michaellomuscio/fulcrum/guide/guide.html

An ELEGOO starter kit project · reinforcement learning · sim to real

# FULCRUM

A cardboard robot that learns to balance a ball in a dream, then does it for real.

- about 3 hours
- no soldering, no 3D printer
- 30 narrated steps, 16 minutes
- brain trains in about a minute

▶ Play the narrated walkthrough Open the Gym

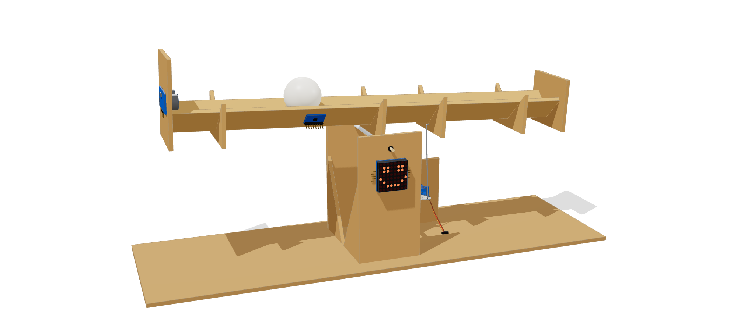
[picture p1: guide/img/hero-wide.png]
The finished Fulcrum: a cardboard V-track on a skewer pivot between two towers, a blue servo with a paperclip push-rod, an ultrasonic sensor at the left end, an LED face, and a ping-pong ball on the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
 the finished robot

0.1

### Welcome

You'll build a robot from a shipping box and your ELEGOO kit that keeps a ping-pong ball wherever you point, on a track that tilts. Nobody writes its balancing rules. A small neural network learns them by reinforcement learning in a simulator you can watch, the Gym. You then send that brain down the USB cable into the Arduino and see whether what it learned in the dream holds up in reality.

Everything here was tested before you build it: the firmware was run on a computer against the simulated robot, calibration was tried on hundreds of deliberately crooked simulated builds, and the brain you'll train beats a hand-tuned classic controller. What I couldn't test is your actual cardboard. That's the experiment.

Done

0.2

### How it works

The trick that makes a dream-trained brain survive reality is domain randomization. Every practice run, the simulator re-rolls the robot's quirks: how sticky the track is, how slow and sloppy the servo is, how noisy the sonar is, how crooked "level" is. A brain that balances in all of those worlds has a good chance in yours.

Done

0.3

### What you need

#### From the kit (names as on the lid)

- UNO R3 Controller Board×1
- USB Cable×1
- 830 Tie-Points Breadboard×1
- Power Supply Module×1
- 9V1A Adapter×1
- Servo Motor SG90 with its bag of plastic arms (horns)×1
- Ultrasonic Sensor the one with two silver "eyes"×1
- GY-521 Module×1
- MAX7219 Module the 8×8 LED matrix×1
- IR Receiver Module and Remote Control×1
- Active Buzzer sticker on top, sealed black bottom×1
- Potentiometer 10K the knob×1
- 100uF Electrolytic Capacitor×1
- Breadboard Jumper Wire×14
- Female-to-Male Dupont Wire×13

#### From home

- Corrugated cardboard one medium shipping box
- Ping-pong ball or a golf ball, or a small rubber ball×1
- Bamboo skewers×2
- Plastic drinking straw×1
- Large paperclip×1
- Hot glue gun and sticks
- Box cutter or sturdy scissors, ruler, pencil
- Double-sided tape or poster putty; clear packing tape is a bonus
- USB-C to USB-A adapter your MacBook's ports are USB-C; the kit cable isn't×1

Done

Part 1

## Build the beam

All cardboard. Hot glue sets in about a minute; hold each joint square until it does. The end with the sensor is "the sonar end" and is at 0 in on every measurement.

1.1

### Cut the cardboard

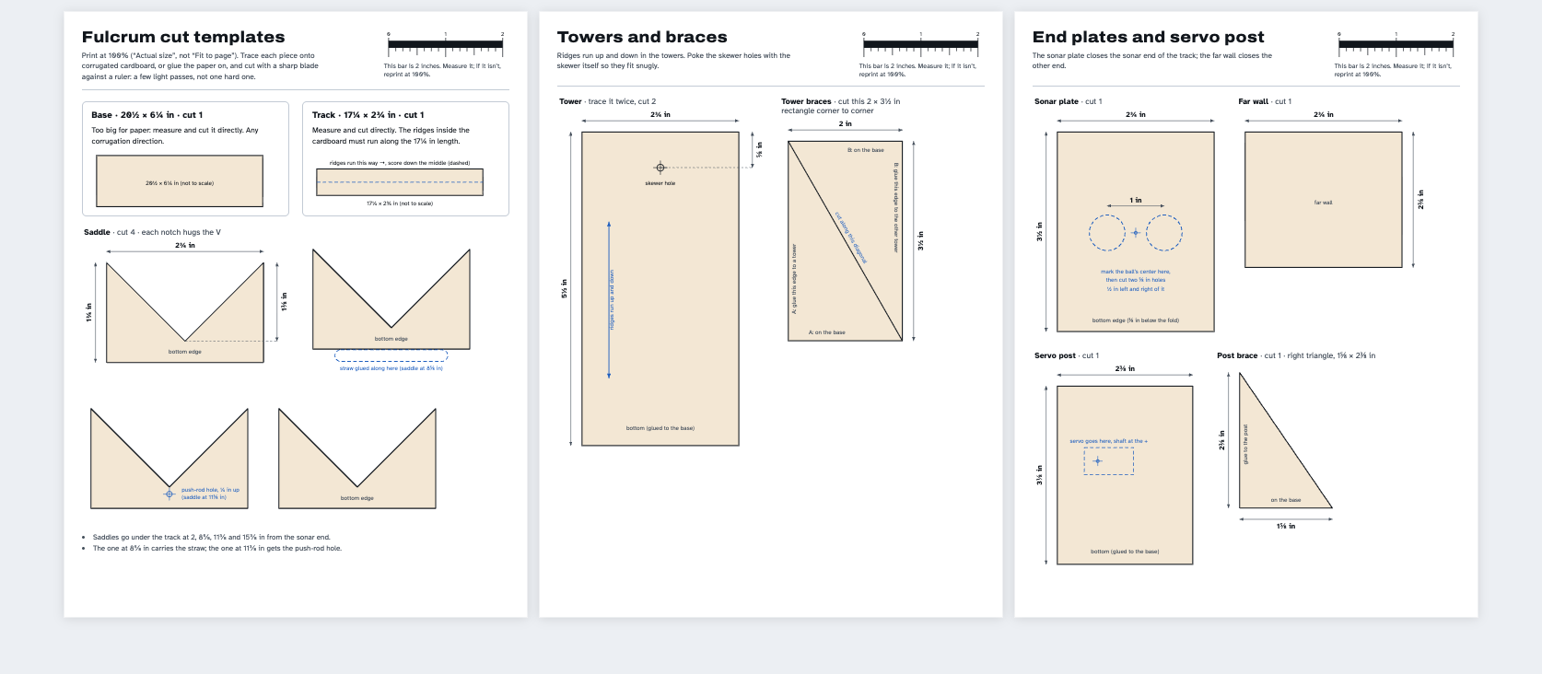
[picture p2: guide/img/templates-preview.png]
Printable cut templates with the small parts drawn at actual size.


Three letter-size pages. Print at 100% (actual size), then check the 2 inch bar with a ruler.

Save the cut templates (PDF)Open them on GitHub (https://github.com/michaellomuscio/fulcrum/blob/main/guide/fulcrum-cut-templates.pdf)

The same file is guide/fulcrum-cut-templates.pdf in the fulcrum folder.

1. Cut the base, 20½ × 6¼ in.
2. Cut the track strip, 17¼ × 2¾ in, with the corrugation (the ridges inside the cardboard) running the 17¼ in way. That keeps it straight.
3. Print the templates, cut them out, trace onto cardboard, and cut: 4 saddles, 2 towers, 2 tower braces, the sonar plate, the far wall, the servo post and its brace.

Clean cuts: several light passes with a sharp blade against a metal ruler beat one hard push. Cut on something you don't mind scratching.

Done

1.2

### Fold the track

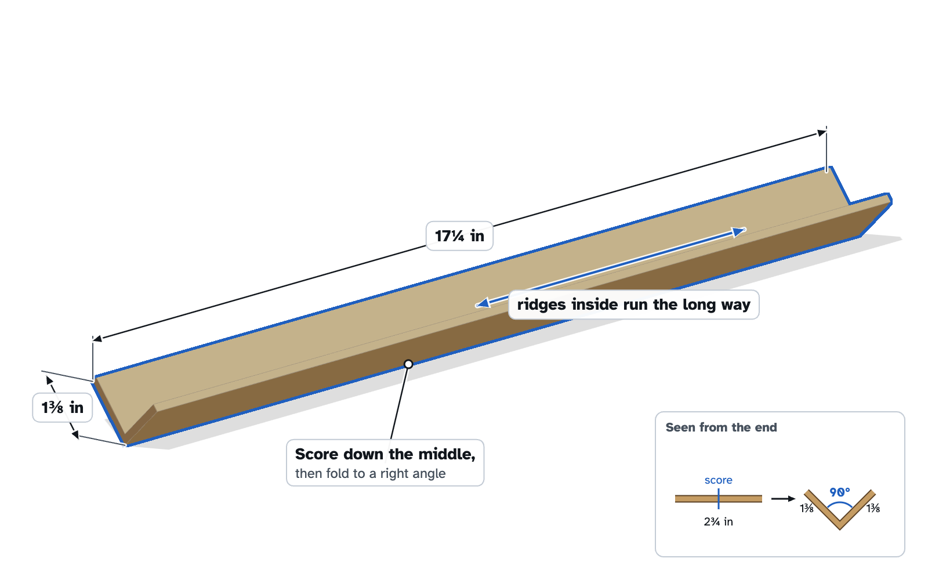
[picture p3: guide/img/build-1-fold.png]
The 17¼ by 2¾ inch strip scored down its middle and folded into a 90 degree V.


1. Draw a line down the middle of the track strip, 1⅜ in from each long edge.
2. Score it: press the back of a butter knife (or a dry ballpoint) firmly along the line, against a ruler.
3. Fold along the score into a V with a right angle, score on the outside.
4. Optional: run clear packing tape down the inside of each face for a smoother, more even roll.

Done

1.3

### Saddles and straw

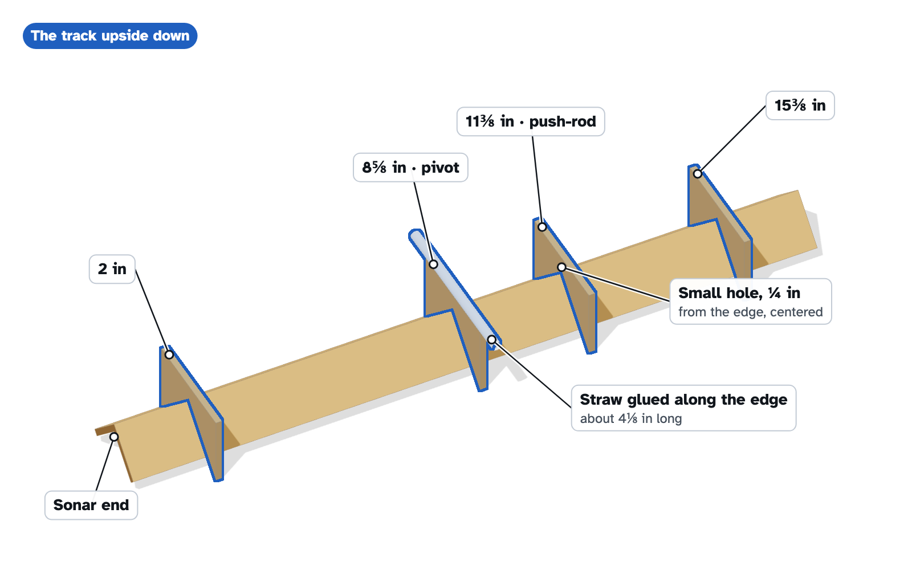
[picture p4: guide/img/build-2-saddles.png]
The track seen from below with four notched saddles at 2, 8⅝, 11⅜ and 15⅜ inches; a straw across the 8⅝ inch saddle and a small hole in the 11⅜ inch saddle.


1. On the outside of the V, mark across it at 2, 8⅝, 11⅜ and 15⅜ in from the sonar end.
2. Cut a straw to 4⅛ in and glue it along the bottom edge of one saddle, centered. That's the pivot saddle.
3. In a second saddle, poke a small hole ¼ in above its bottom edge, centered, with a skewer tip. That's the push-rod saddle.
4. Glue the saddles on the marks with their notches hugging the V: pivot saddle at 8⅝, push-rod saddle at 11⅜, the plain ones at 2 and 15⅜. The straw runs across the track.

Done

1.4

### Sonar plate and far wall

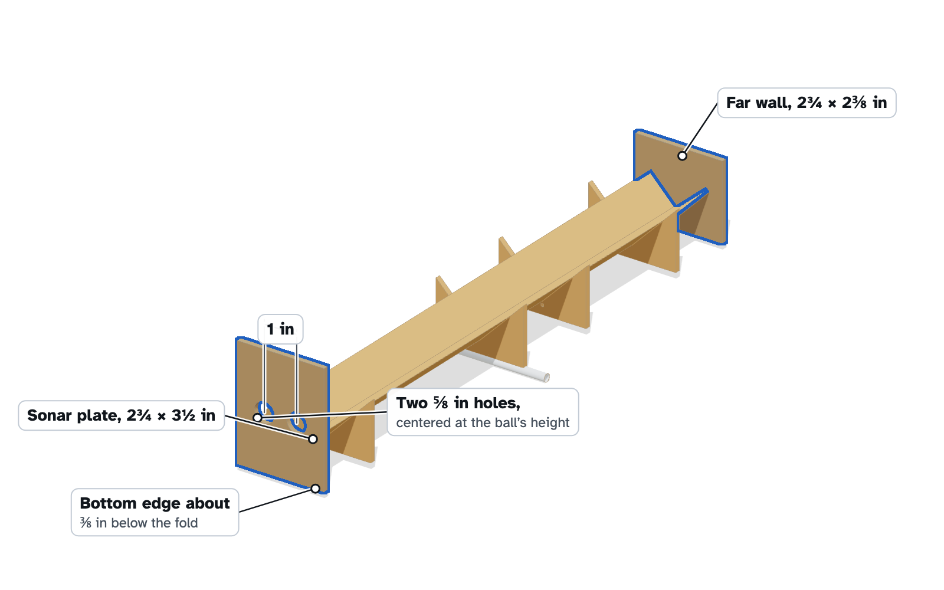
[picture p5: guide/img/build-3-ends.png]
The sonar plate with two round holes across the sonar end of the track, and the far wall across the other end.


1. Hold the sonar plate across the sonar end, set the ball in the V against it, and mark the plate at the height of the ball's center.
2. Draw two ⅝ in circles centered ½ in left and right of the mark (1 in apart), and cut them out. The sensor's silver cans should just fit.
3. Glue the plate across the end, centered on the V, its bottom edge about ⅜ in below the fold.
4. Glue the far wall across the other end.

Done

1.5

### Towers

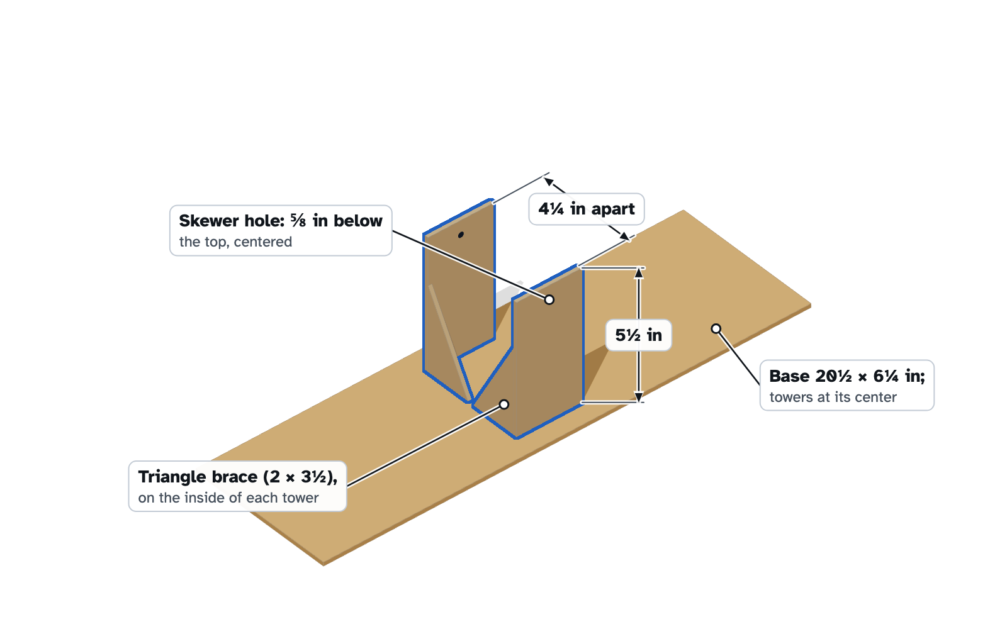
[picture p6: guide/img/build-4-towers.png]
Two cardboard towers standing on the base, 4¼ inches apart, each with a skewer hole ⅝ inch below the top and a triangular brace on its inside face.


1. Poke a skewer hole in each tower, ⅝ in below the top, centered.
2. Draw a line across the base at its middle (10¼ in from either end). Glue the towers upright on that line, facing each other, 4¼ in apart (inside faces), centered across the base.
3. Before the glue sets, slide a skewer through both holes so they line up.
4. Glue a triangle brace against the inside face of each tower, along the edge nearest the sonar end. (On the outside they'd hang off the base.)

Done

1.6

### Hang the beam

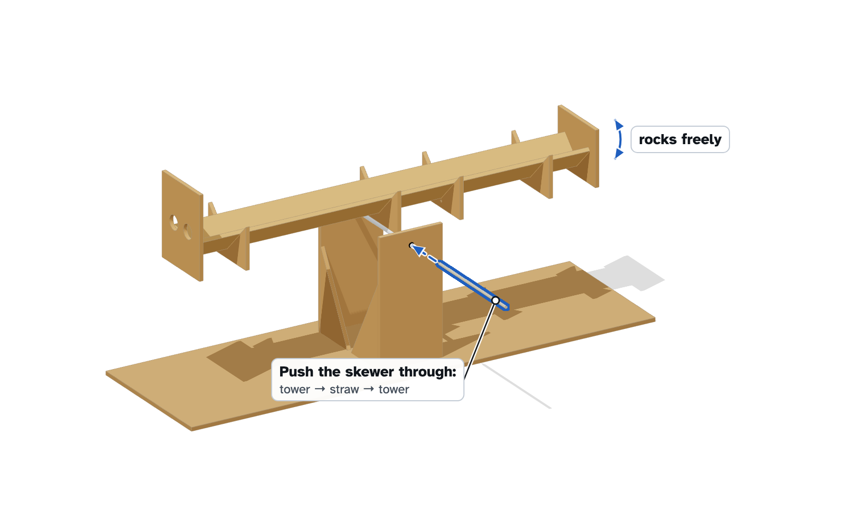
[picture p7: guide/img/build-5-hang.png]
The track hanging on a skewer that passes through one tower, the straw, and the other tower.


1. With the sonar end on your left, push a skewer through one tower, through the straw, and out the other tower.
2. Nudge the beam. It should rock freely and settle without sticking. If it rubs, trim the straw.
3. Trim the skewer so about ½ in sticks out past each tower.

The servo goes on in Part 4, once the electronics have been tested.

Done

Part 2

## Wire the electronics

Do this on the table, in front of the robot near the sonar end, with nothing plugged into your Mac or the wall. In each diagram the new wires are in full color and earlier ones are faded. Any hole on the correct rail works; the diagrams show a tidy layout that keeps everything in the left half of the board.

2.1

### Power

Wiring diagram: the power supply module on the left end of the breadboard; Arduino 5V and GND to the bottom rails; a ground bridge between the blue rails.

1. Press the Power Supply Module onto the left end of the breadboard: its − pins on the blue stripes, + pins on the red stripes, DC jack facing out.
2. Top jumper on 5V. Bottom jumper on OFF.
3. Red jumper: Arduino 5V → bottom red (+) rail. Black jumper: Arduino GND → bottom blue (−) rail.
4. Black jumper: top blue rail → bottom blue rail, so both supplies share a ground.

Why two supplies: the servo pulls sudden bursts of current that would jolt the sensors' readings. The top rail (power module) feeds only the servo; the bottom rail (the Arduino's own 5 V) feeds everything else.

Done

2.2

### Servo

Wiring diagram: capacitor across the top rails; servo brown to top blue, red to top red, orange to pin 9.

From | To
Capacitor, long leg | top red (+) rail
Capacitor, striped leg | top blue (−) rail (polarity matters)
Servo brown | top blue (−) rail
Servo red | top red (+) rail
Servo orange | Arduino pin 9

Done

2.3

### Ultrasonic sensor

Wiring diagram: HC-SR04 VCC to bottom red rail, Trig to pin 7, Echo to pin 8, Gnd to bottom blue rail.

Sensor pin | Female-to-male wire to
VCC | bottom red (+) rail
Trig | Arduino pin 7
Echo | Arduino pin 8
Gnd | bottom blue (−) rail

Done

2.4

### Motion sensor (GY-521)

Wiring diagram: GY-521 VCC and GND to the bottom rails, SCL to A5, SDA to A4.

Board pin | Female-to-male wire to
VCC | bottom red (+) rail
GND | bottom blue (−) rail
SCL | Arduino A5
SDA | Arduino A4
XDA, XCL, AD0, INT | nothing

ELEGOO ships this board with either an MPU-6050 or a QMI8658 chip. The firmware finds whichever you have.

Done

2.5

### Knob

Wiring diagram: potentiometer legs in three columns; left to the bottom blue rail, middle to A0, right to the bottom red rail.

1. Push the knob's three legs into three different columns (some knobs need every other column).
2. Left leg → bottom blue rail. Middle leg → A0. Right leg → bottom red rail.

If turning the knob moves the target the opposite way from what you'd like, swap the two outer wires.

Done

2.6

### LED face

Wiring diagram: MAX7219 module VCC and GND to the bottom rails, DIN to pin 11, CS to pin 10, CLK to pin 13.

Matrix pin | Female-to-male wire to
VCC | bottom red (+) rail
GND | bottom blue (−) rail
DIN | Arduino pin 11
CS | Arduino pin 10
CLK | Arduino pin 13

Done

2.7

### Remote receiver

Wiring diagram: IR receiver module pins G, R, Y in three columns; G to the bottom blue rail, R to the bottom red rail, Y to pin 2.

1. Plug the receiver into three columns with its dark dome facing the front edge of the breadboard.
2. G → bottom blue rail. R → bottom red rail. Y → Arduino pin 2.

Done

2.8

### Buzzer

Wiring diagram: active buzzer plus leg to pin 3, minus leg to the bottom blue rail.

1. Use the active buzzer: sticker on top, sealed black bottom. (The passive one shows a green circuit board underneath.)
2. Longer leg (marked +) → Arduino pin 3. Other leg → bottom blue rail.

Done

2.9

### Check the wiring

The complete wiring diagram.

Arduino pin | Goes to
D2 | remote receiver Y
D3 | buzzer +
D7 | sonar Trig
D8 | sonar Echo
D9 | servo orange
D10 | LED matrix CS
D11 | LED matrix DIN
D13 | LED matrix CLK
A0 | knob middle leg
A4 | GY-521 SDA
A5 | GY-521 SCL
5V, GND | bottom red and blue rails

Three things to double-check: the capacitor's stripe faces the blue rail; the power module's + and − line up with the red and blue stripes; and nothing from the bottom rails touches the top red rail, which belongs to the servo alone.

Done

Part 3

## Bring it to life

Everything from here on happens in the Gym, a web app in the fulcrum folder on your Mac. It has three tabs: Dream (training), Exam (testing) and Robot (the USB connection).

3.1

### Open the Gym

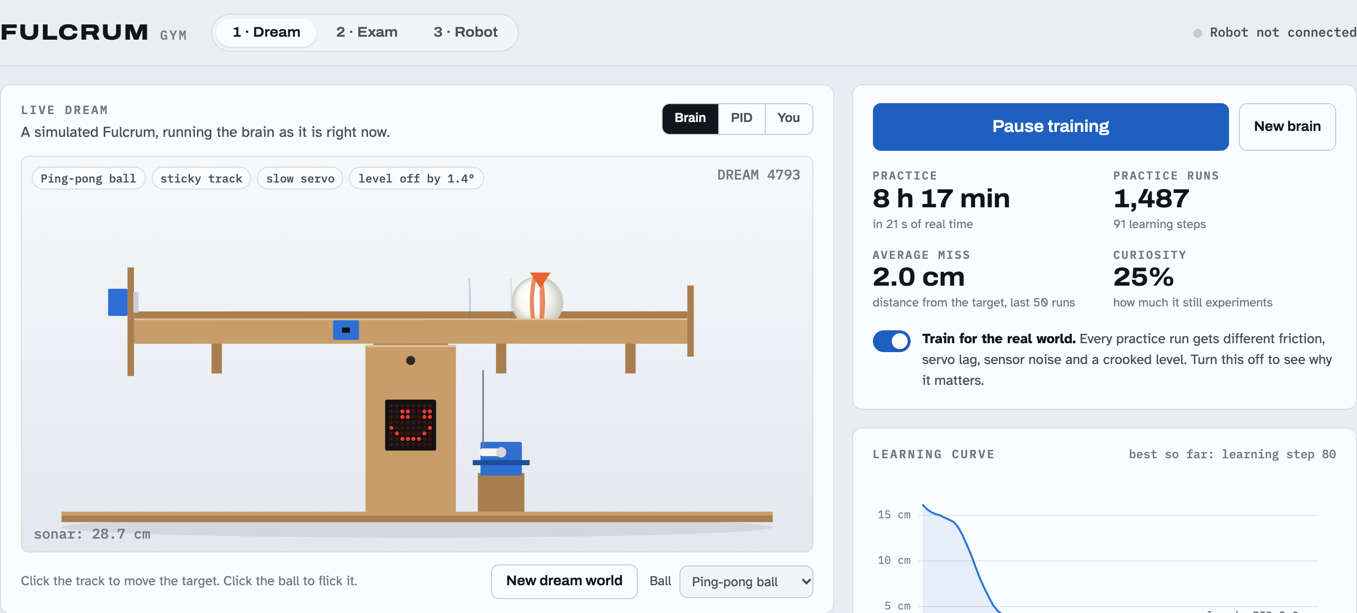
[picture p8: guide/img/gym-dream.png]
The Gym's Dream tab: a simulated Fulcrum, practice thumbnails, a learning curve and the brain's decision map.


1. Open the Gym in Chrome at michaellomuscio.github.io/fulcrum/gym. It can reach the Arduino over USB from there.
2. Or run it from your Mac, which also works offline: in Finder, open the fulcrum folder and double-click Fulcrum Gym.command. Chrome shows the Gym at localhost:8642/gym/; keep the small Terminal window open while you work. (Not on a Mac? Run python3 -m http.server 8642 in the folder.)

USB needs Chrome or Edge; Safari and Firefox don't support it. A Gym opened from inside claude.ai can train, run exams and drive a virtual robot, but can't reach USB.

Done

3.2

### Install the firmware

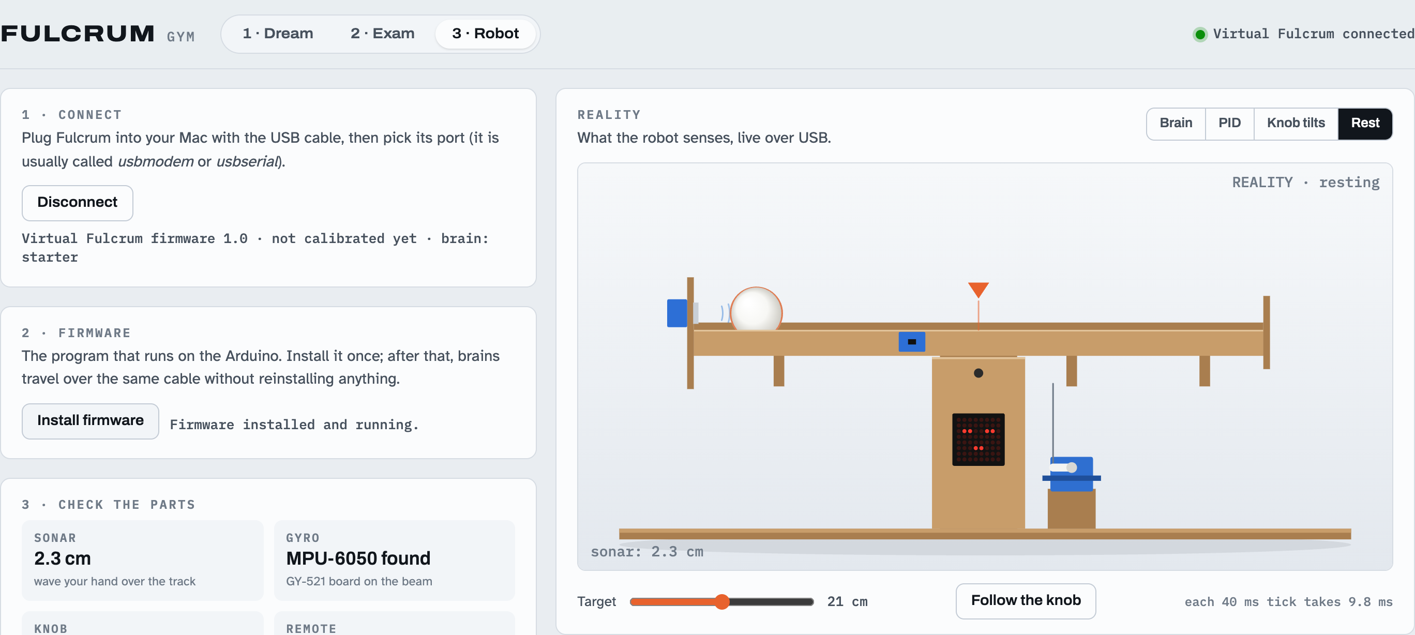
[picture p9: guide/img/gym-firmware.png]
The Robot tab after connecting and installing the firmware.


1. Plug the Arduino into your Mac (through the USB-C adapter).
2. In the Robot tab, click Connect and pick the port named like usbmodem… or usbserial….
3. Click Install firmware. About ten seconds later Fulcrum beeps twice and the status line says hello.

Plan B, the Arduino IDE: open fulcrum/firmware/Fulcrum/Fulcrum.ino, choose Tools › Board › Arduino Uno and your port, then Upload. No extra libraries are needed. Or flash it from Terminal with arduino-cli (see the README).

Done

3.3

### Test every part

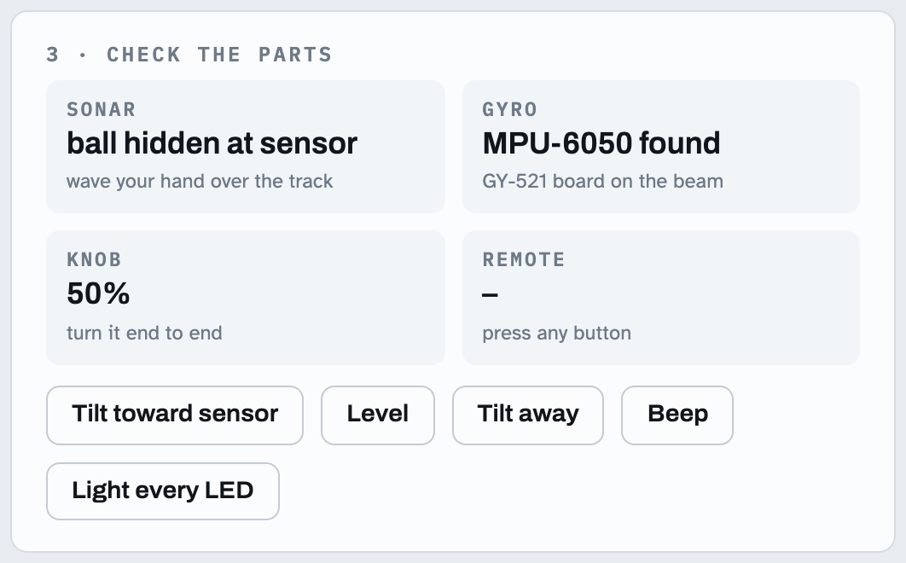
[picture p10: guide/img/gym-checks.png]
The Check the parts panel with live sonar, gyro, knob and remote readings.


1. Plug the 9 V adapter into the power module and press its button (its LED lights).
2. Wave a hand over the sonar: the reading changes. The gyro says found. Turn the knob end to end. Press any remote button.
3. Click Beep and Light every LED.
4. Click Tilt toward sensor, Level and Tilt away: the servo's shaft turns.

Something silent? See Troubleshooting. Fixing it now, with everything on the table, is much easier than later.

Done

Part 4

## Finish the robot

Mount the servo while the firmware holds it at its exact middle, then move the sensors onto the beam and let Fulcrum calibrate itself.

4.1

### Servo and push-rod

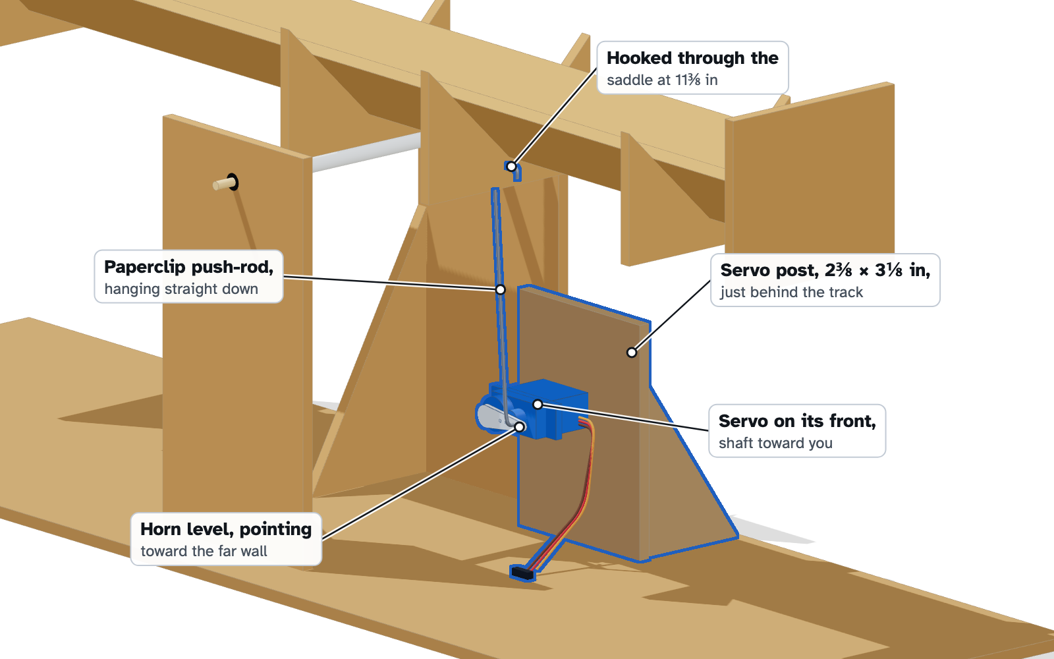
[picture p11: guide/img/build-6-servo.png]
The servo glued to a cardboard post behind the track, its arm horizontal toward the far wall, a paperclip rod rising to the saddle at 11⅜ inches.


1. Click Level in the Gym so the servo holds its middle position.
2. Glue the servo post to the base right behind the push-rod saddle (11⅜ in), its front face 1⅜ in behind the track's center line, and add its brace behind it.
3. Glue the servo to the post's front face with the shaft pointing toward you, about 2 in above the base, just left of the push-rod saddle (by the length of the arm).
4. Push the long single arm onto the shaft, pointing at the far wall, as close to horizontal as the teeth allow.
5. Straighten the paperclip. Hook one end through the arm's outermost hole and squeeze the hook closed; hook the top end through the saddle's hole the same way. Bend the rod until the beam sits close to level.

No glue on the rod's joints. They have to pivot.

Done

4.2

### Mount the sensors

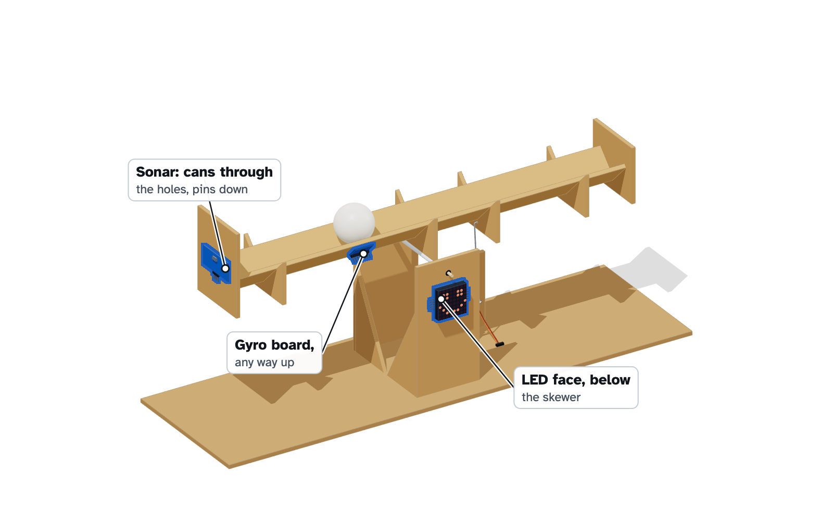
[picture p12: guide/img/build-7-sensors.png]
The ultrasonic sensor through the plate's holes, the GY-521 on the track's side, and the LED matrix on the front tower.


1. Push the ultrasonic sensor's cans through the plate's holes from outside, pins pointing down, and tape the board in place.
2. Stick the GY-521 to the outside of the track near 6 in with double-sided tape. Any orientation works; calibration figures it out.
3. Stick the LED matrix to the front tower below the skewer, facing you.
4. Route the wires loosely so the beam swings without tugging on them.

Done

4.3

### Calibrate

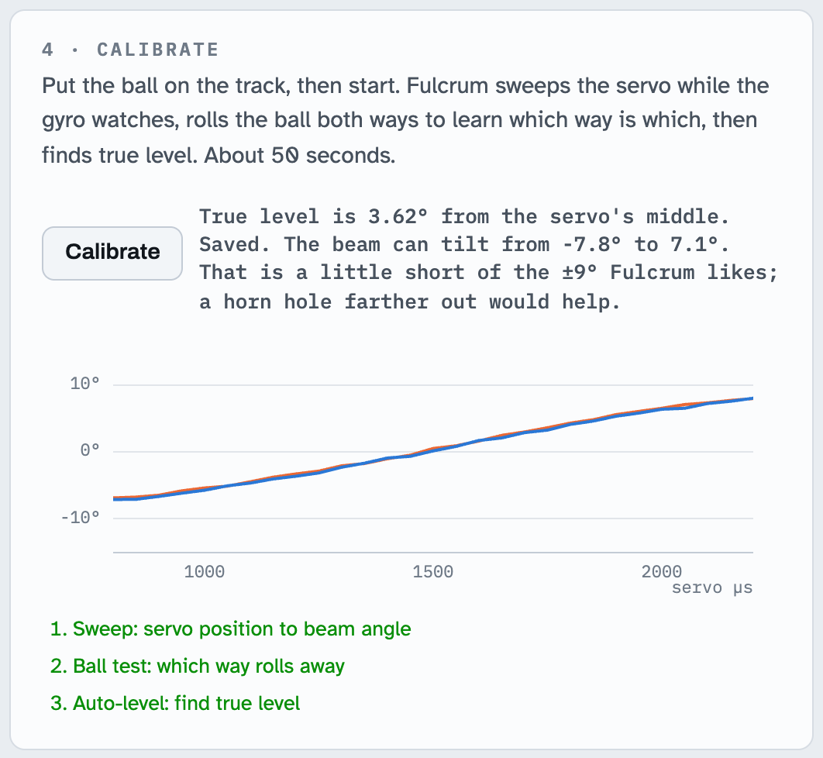
[picture p13: guide/img/gym-calibrate.png]
The calibration panel: a curve of beam angle against servo position, and three completed calibration steps.


1. Put the ball on the track and click Calibrate (or press ST/REPT on the remote). It takes about 50 seconds.
2. Sweep: the servo moves slowly end to end while the gyro measures the beam, giving a map from servo position to beam angle.
3. Ball test: it tilts one way, back, and again, and watches which way the ball rolls.
4. Auto-level: it holds the ball mid-track and nudges until it finds true level. The result is saved on the Arduino.

If it reports that the ball didn't roll, check that the ball is on the track and that the beam sits roughly level at rest (adjust the push-rod's bends), then calibrate again.

Done

Part 5

## Teach it

The robot can already balance with the starter brain I trained. Now train your own, examine it, and send it over.

5.1

### Train a brain

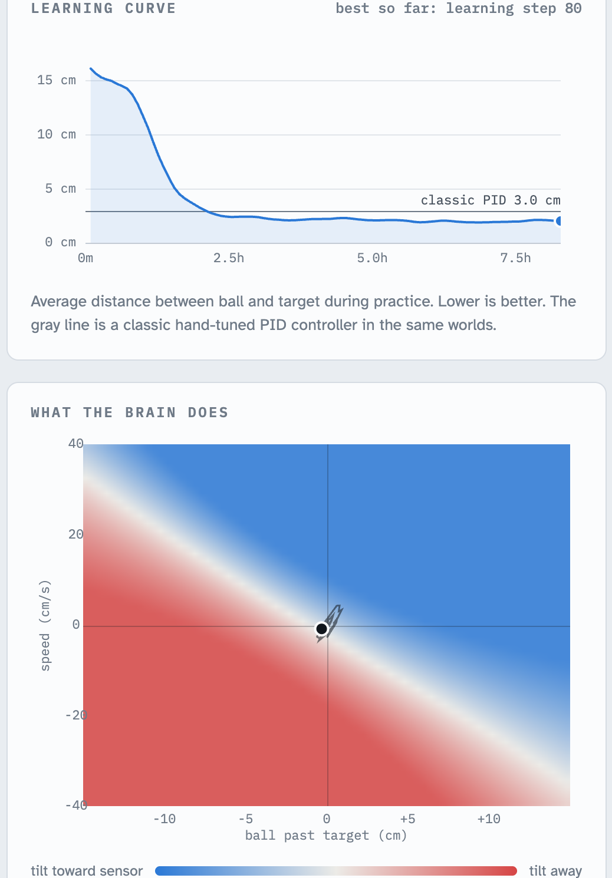
[picture p14: guide/img/gym-train.png]
The Dream tab during training: the learning curve dropping below the classic controller's line, and the brain's decision map.


1. In the Dream tab, press Start training. Sixty-four simulated Fulcrums practice at once, each with different physics.
2. Watch the learning curve: it climbs while the brain explores, then drops below the gray line, the score of a classic hand-tuned controller.
3. Watch What the brain does: a clean diagonal forms as it learns that the right tilt depends on both where the ball is and how fast it rolls.
4. Two or three minutes is plenty. Click the track to move the target, click the ball to flick it, or press You and try balancing it yourself.

Done

5.2

### The exam

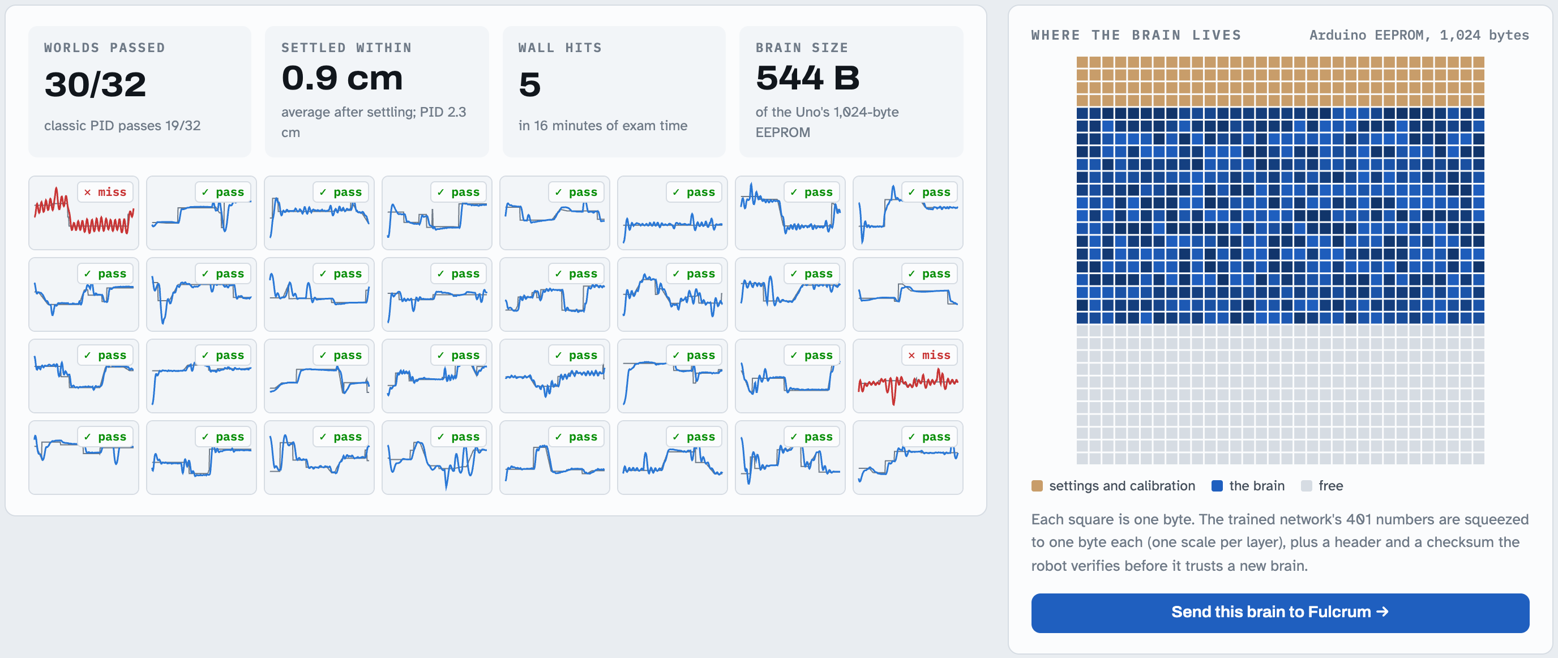
[picture p15: guide/img/gym-exam.png]
The Exam tab: 32 small charts of exam worlds with pass marks, score tiles, and a map of the Arduino's memory.


1. Open Exam, choose Best so far, and click Run the exam.
2. It's graded on the 544-byte, 8-bit copy the Arduino will run. Passing most of the 32 worlds means it's ready.

Done

5.3

### Send the brain

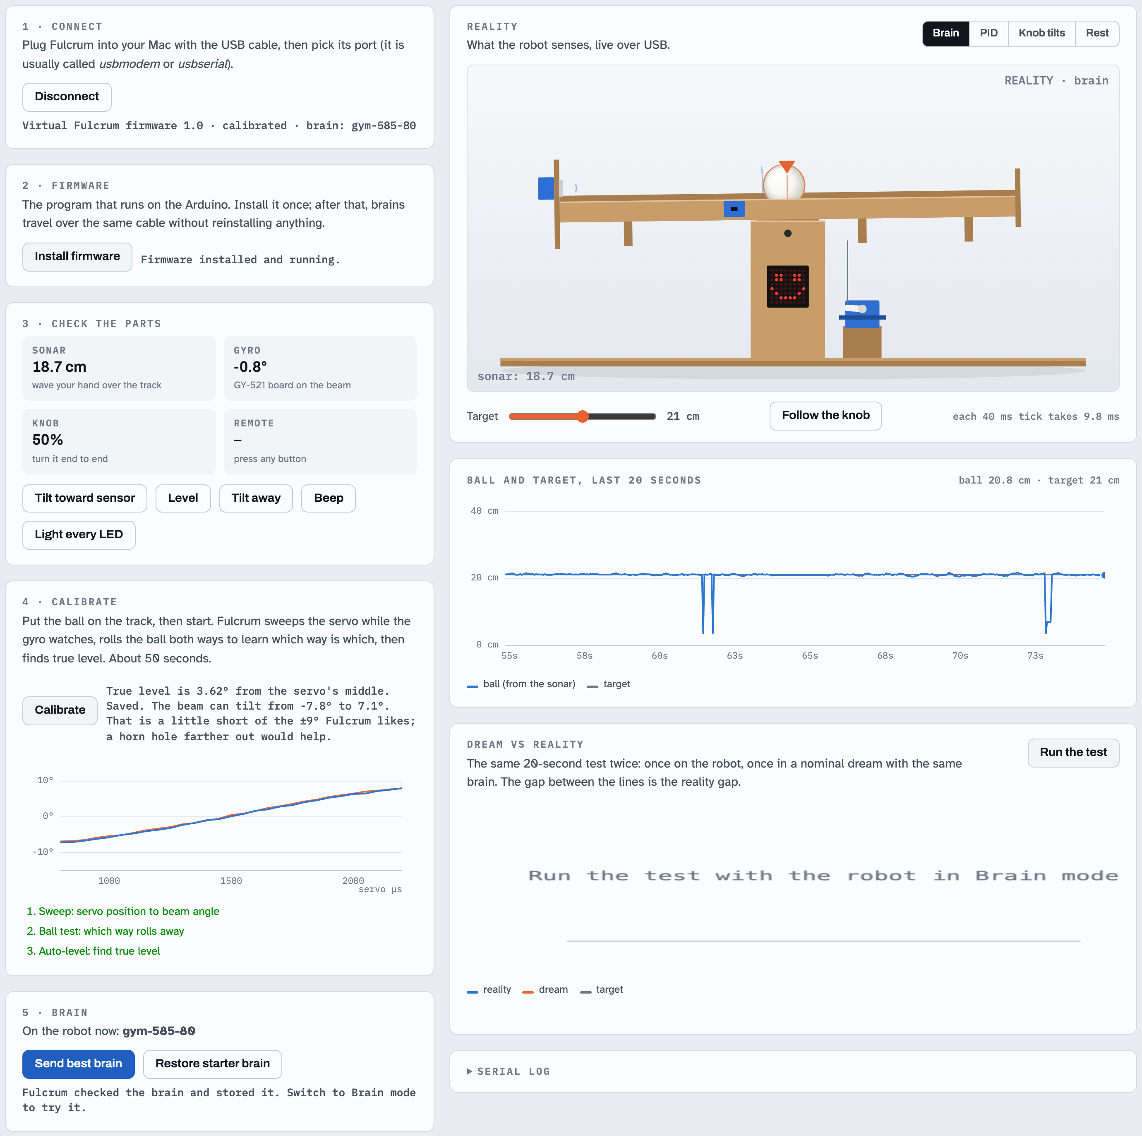
[picture p16: guide/img/gym-send.png]
The Robot tab's brain panel after sending a new brain, with the live view in Brain mode.


1. In Robot, click Send best brain. The Arduino checks every piece and stores the brain in memory that survives power-off.
2. Choose Brain mode, set the ball on the track, and let go.

Done

5.4

### Play with it

Button | What Fulcrum does
POWER or ▶❚❚ | start balancing, or rest
FUNC/STOP | switch brain → classic PID → knob tilts the beam (you're the brain)
1 … 9 | send the ball to a spot: 1 is nearest the sensor, 9 is farthest
0 | hand the target back to the knob
▲ ▼ | nudge the target 1 cm
VOL+ VOL− | fine-tune level by 0.05°
◀◀ ▶▶ | face, neurons, or a tiny copy of the beam on the LED matrix
EQ | buzzer on or off
ST/REPT | calibrate

Unplugged from the Mac, Fulcrum keeps its brain and calibration. Power the Arduino with the 9 V battery (or a USB power bank) and the servo with the adapter, then press POWER on the remote.

Done

5.5

### Dream vs reality

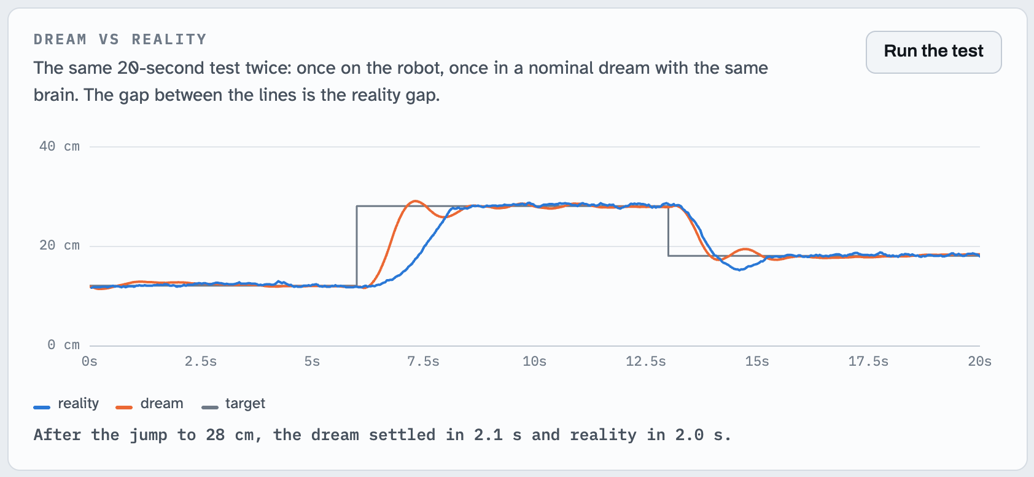
[picture p17: guide/img/gym-dreamreal.png]
Chart: the ball's position on the robot and in the simulator during the same 20-second routine of target changes.


1. In Robot, with Brain mode on, click Run the test. Fulcrum runs a 20-second routine of target jumps on the real track, then the Gym dreams the same routine with the same brain.
2. The space between the blue and orange lines is the reality gap. Small gap: the dream was a good model of your cardboard.

The screenshot above is the virtual robot, whose physics are deliberately different from the dream's. Yours will tell you how good the simulator really is.

Done

5.6

### Experiments

1. Skip the randomization. Turn off Train for the real world, train a new brain, send it. It aces its one perfect dream and struggles on real cardboard.
2. Change the ball. Try a golf ball (pick it in the Gym first). Does the brain cope with a heavier, faster ball?
3. Watch it learn from scratch. Press New brain and keep your eye on the decision map. The moment the diagonal appears is when it figured out balancing.
4. Beat the classic controller. Run the dream-vs-reality test in Brain mode and in PID mode and compare.
5. Be the brain. FUNC/STOP until the knob tilts the beam, and try to hold the ball still. Then let the brain have it back.

Done

Reference

## Troubleshooting

What you see | Usual cause and fix
No port to pick in Connect | Try another cable or adapter (some USB-C adapters are charge-only). Use Chrome; Safari has no USB support.
Connected, but no hello | Firmware not installed yet: click Install firmware. Or the Arduino IDE's Serial Monitor is open and holding the port; close it.
Install firmware says it can't reach the bootloader | Unplug and replug the Arduino, reconnect, try again. Still failing: use Plan B (Arduino IDE).
Sonar: no echo | Trig and Echo swapped (pin 7 is Trig, 8 is Echo), or VCC/Gnd loose. The cans must face down the track.
Gyro: not found | SDA/SCL swapped (SDA is A4, SCL is A5) or VCC loose. Fulcrum still works without it, with a less precise calibration.
Servo doesn't move, or twitches and the Arduino resets | Power module off or the 9 V adapter unplugged; top jumper not on 5V; capacitor backwards; servo red wire on the bottom rail.
Remote does nothing | Y must go to pin 2; aim at the receiver's dome; replace the remote's coin cell (pull the plastic tab out first).
LED face is sideways or upside down | Click Rotate face in the Gym's Check the parts panel until it looks right (it remembers).
Ball always runs off to one end | Calibrate again with the ball on the track. If the ball test fails, the beam is far from level at rest: re-bend the push-rod.
Ball hunts back and forth around the target | Loose push-rod joints add slop (tighten the hooks, but keep them free to turn). Train a little longer. Make sure the wires aren't tugging the beam.

Reference

## How it works, for the curious

The real equations behind the simulator, the learner and the robot.

### The physics in the dream

Put the pivot at the origin, let s be the ball's position along the track measured from the pivot, θ the beam angle (positive tips the far end down), h the height of the ball's center above the pivot, rc the ball's rolling radius on the V, m and J its mass and moment of inertia. Rolling without slipping makes the ball's spin ω = ṡ/rc + θ̇, so

kinetic energy of the ball's center and its spin, minus gravity

differentiate the momentum along the track

centrifugal push and gravity's pull along the track

Euler–Lagrange, divided through by m + J/rc²

A ping-pong ball is a thin shell, J = ⅔mr², and in a 90° V it rolls on a radius rc = r/√2, so k = 1/(1 + 4/3) = 3/7 ≈ 0.43: only 43% of gravity's pull along the track becomes acceleration; the rest spins the ball. The heffθ̈ term is the kick the ball gets when the beam jerks. The simulator adds rolling friction that sticks below a threshold, bumps in the cardboard, a servo modeled as a stiff damped spring with dead time, speed and torque limits, gear slop, and an ultrasonic sensor with noise, dropouts, garbage echoes and a blind spot.

### What the brain sees and does

The sonar's readings go through an alpha-beta tracker (the same arithmetic on the Arduino and in the dream):

The brain is a 6 → 16 → 16 → 1 network with tanh neurons. Its inputs are the miss e = x̂ − target (scaled by 15 cm), the speed (scaled by 40 cm/s), its last two tilts, the integral of the miss (scaled by 0.05 m·s), and where the ball is. Its output, between −1 and 1, is the tilt in units of 7°.

### How it learns: PPO

Each practice step earns a reward for being close and calm:

Proximal Policy Optimization nudges the brain toward actions that turned out better than a second network, the critic V, expected, while never changing the policy too much at once:

The critic is allowed to peek at the dream's hidden physics (the true level error, the true ball position), which makes its estimates better; the brain that ships to the robot only ever sees the sensor. That split is called an asymmetric actor-critic. Training runs 64 worlds in parallel, 8,192 decisions per learning step.

### Fitting it into 1 KB

Each layer's weights are stored as signed bytes with one scale per layer, w ≈ s·q, q = round(w/s), s = max|w|/127, so a neuron computes b + s·Σqkxk. The whole brain is 544 bytes with its header and CRC-32 checksum. The exam grades exactly this copy, and on a desktop the firmware's C++ matches the Gym's JavaScript to within 10⁻⁷.

### Calibration without knowing how the gyro is mounted

Fulcrum reads which way is "up" (u) at the servo's middle and at both extremes (gA, gB). The pivot axis is n = (gA × gB)/|gA × gB|, and any later reading's beam angle is

which doesn't care which way the board faces. Level comes from the ball itself: a gentle controller holds it mid-track while a correction creeps toward wherever the ball drifts; averaged over ten seconds, the tilt that keeps the ball still is true level.

### What I tested before you build

0.43 cm

median settling error after calibration, across 100 randomly crooked simulated builds (90th percentile 0.70 cm, no wall hits)

99 / 100

simulated builds that calibrated, including a gyro stuck on at random angles and level errors up to ±6°

30 / 32

exam worlds passed by the starter brain; a hand-tuned PID controller passes 19

The real firmware was compiled for the Uno (27.9 KB of 32 KB flash, 790 bytes of RAM to spare) and also run on a Mac against the simulated robot: it calibrates, balances as well as the simulator predicts, accepts new brains and refuses a corrupted one. None of this is a promise about your cardboard. That's what the dream-vs-reality test is for.

Reference

## What's in the folder

Everything is also on GitHub: github.com/michaellomuscio/fulcrum.

Fulcrum Gym.command | double-click to open the Gym in Chrome (needed for USB)
firmware/Fulcrum/ | the Arduino program (Fulcrum.ino plus helpers). PROTOCOL.md lists its USB commands.
gym/ | the Gym web app; gym/firmware_hex.js is the compiled firmware it installs
core/ | shared code: the simulator, the PPO learner, the brain packer, calibration, and spec.js, the single source of every constant
guide/ | this guide, its narration, illustrations, and fulcrum-cut-templates.pdf
tools/ | headless training, the exam, and the tests that compare the firmware with the simulator
BUILD_SPEC.md | every dimension, position and wire, in one place

Fulcrum, built with Claude Code for an ELEGOO Most Complete Starter Kit. Narration voiced offline with Kokoro (af_heart). Source: github.com/michaellomuscio/fulcrum.

◀◀ ❚❚ ▶▶

✕
