michaellomuscio/fulcrum/guide/templates.html

# Fulcrum cut templates

Print at 100% (“Actual size”, not “Fit to page”). Trace each piece onto corrugated cardboard, or glue the paper on, and cut with a sharp blade against a ruler: a few light passes, not one hard one.

This bar is 2 inches. Measure it; if it isn’t, reprint at 100%.

Base · 20½ × 6¼ in · cut 1Too big for paper: measure and cut it directly. Any corrugation direction.

Track · 17¼ × 2¾ in · cut 1Measure and cut directly. The ridges inside the cardboard must run along the 17¼ in length.

Saddle · cut 4 · each notch hugs the V

- Saddles go under the track at 2, 8⅝, 11⅜ and 15⅜ in from the sonar end.
- The one at 8⅝ in carries the straw; the one at 11⅜ in gets the push-rod hole.

# Towers and braces

Ridges run up and down in the towers. Poke the skewer holes with the skewer itself so they fit snugly.

This bar is 2 inches. Measure it; if it isn’t, reprint at 100%.

Tower · trace it twice, cut 2

Tower braces · cut this 2 × 3½ in
rectangle corner to corner

# End plates and servo post

The sonar plate closes the sonar end of the track; the far wall closes the other end.

This bar is 2 inches. Measure it; if it isn’t, reprint at 100%.

Sonar plate · cut 1

Far wall · cut 1

Servo post · cut 1

Post brace · cut 1 · right triangle, 1⅝ × 2⅜ in
