michaellomuscio/fulcrum/guide/wiring-preview.html

# Fulcrum wiring, step by step

W1 · Power

Power wiring

W2 · Servo and capacitor

Servo wiring

W3 · Sonar

Sonar wiring

W4 · Gyro

Gyro wiring

W5 · Knob

Knob wiring

W6 · LED face

LED matrix wiring

W7 · IR receiver

IR receiver wiring

W8 · Buzzer

Buzzer wiring

Everything

All wiring
