michaellomuscio/fulcrum/guide/fulcrum-cut-templates.pdf

### Fulcrum cut templates

Print at 100% (“Actual size”, not “Fit to page”). Trace each piece onto corrugated cardboard, or glue the paper on, and cut with a sharp blade against a ruler: a few light passes, not one hard one.

0 | 1 | 2

This bar is 2 inches. Measure it; if it isn’t, reprint at 100%.

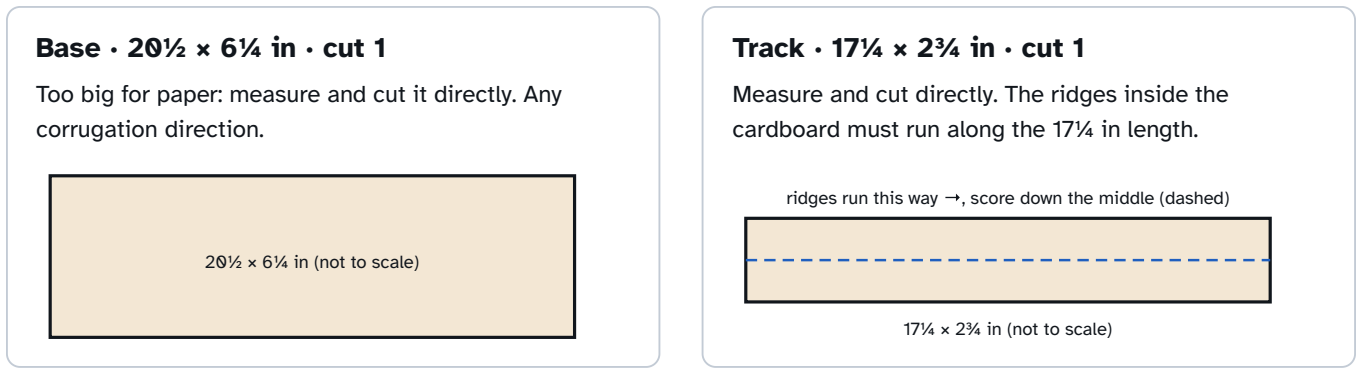
[picture p18: figure]
Base · 20½ × 6¼ in · cut 1; corrugation direction.; 20½ × 6¼ in (not to scale); Track · 17¼ × 2¾ in · cut 1; 17¼ × 2¾ in (not to scale)

Too big for paper: measure and cut it directly. Any

Measure and cut directly. The ridges inside the cardboard must run along the 17¼ in length.

ridges run this way →, score down the middle (dashed)

Saddle · cut 4 · each notch hugs the V

bottom edge

2¾ in

1¾ in

1⅜ in

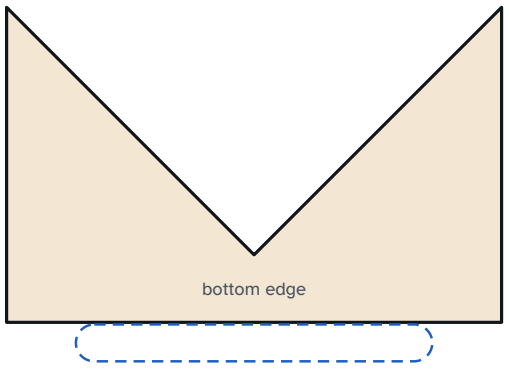
[picture p19: figure]
bottom edge

straw glued along here (saddle at 8⅝ in)

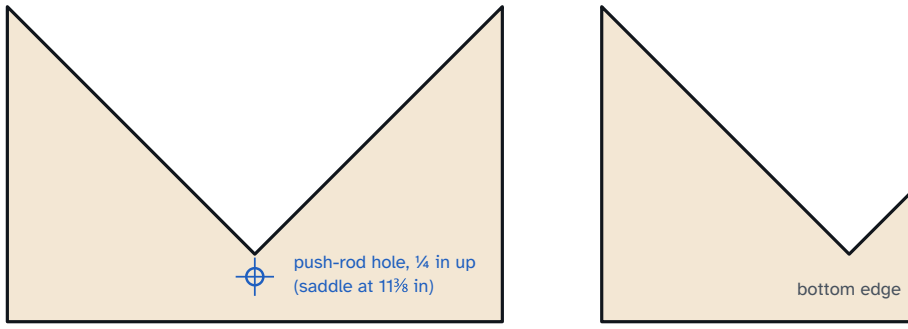
[picture p20: figure]
push-rod hole, ¼ in up; (saddle at 11⅜ in); bottom edge

Saddles go under the track at 2, 8⅝, 11⅜ and 15⅜ in from the sonar end. The one at 8⅝ in carries the straw; the one at 11⅜ in gets the push-rod hole.

### Towers and braces

Ridges run up and down in the towers. Poke the skewer holes with the skewer itself so they fit snugly.
This bar is 2 inches. Measure it; if it isn’t, reprint at 100%.

Tower · trace it twice, cut 2 2¾ in

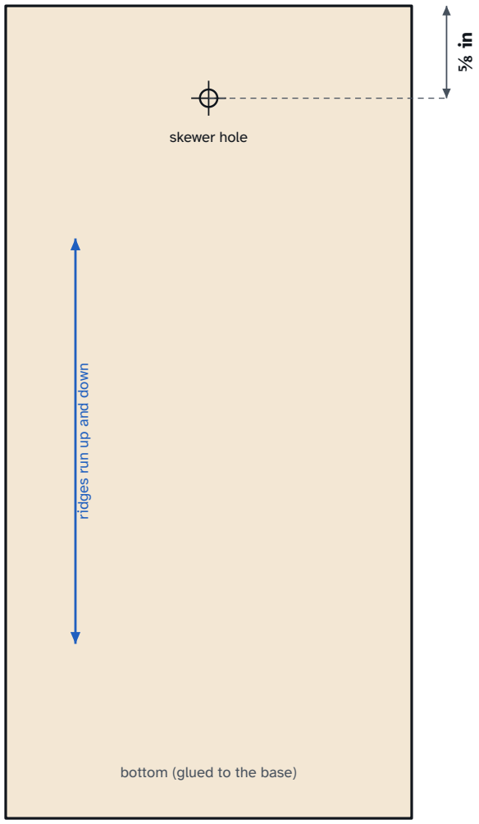
[picture p21: figure]
skewer hole; ridges run up and down; bottom (glued to the base)

5

½ in

Tower braces · cut this 2 × 3½ in rectangle corner to corner

A: glue this edge to a tower

A: on the base

B: glue this edge to the other tower

B: on the base

cut along this diagonal

### 2 in

3

½ in

### End plates and servo post

The sonar plate closes the sonar end of the track; the far wall closes the other end.
This bar is 2 inches. Measure it; if it isn’t, reprint at 100%.

Sonar plate · cut 1
2¾ in

3

½ in

Far wall · cut 1

far wall

2¾ in

2

⅜ in

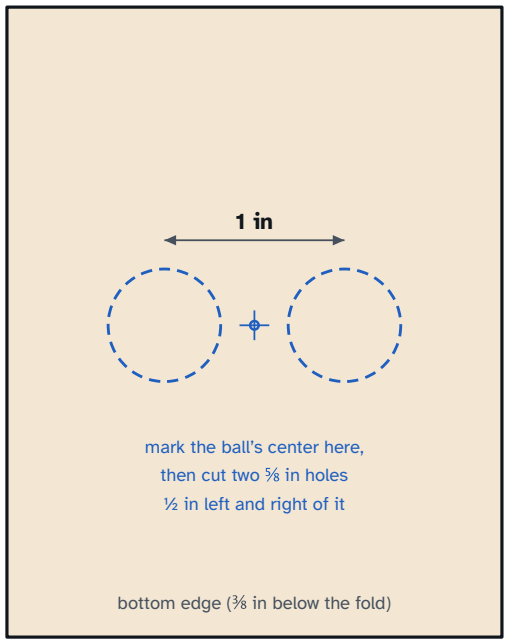
[picture p22: figure]
mark the ball’s center here, then cut two ⅝ in holes ½ in left and right of it; bottom edge (⅜ in below the fold)

Servo post · cut 1
2⅜ in

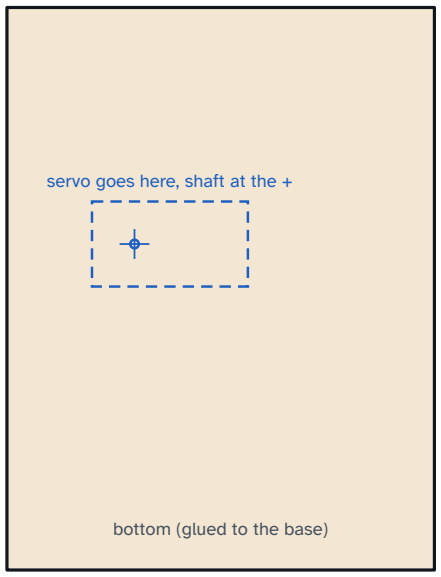
[picture p23: figure]
servo goes here, shaft at the +; bottom (glued to the base)

3

⅛ in

Post brace · cut 1 · right triangle, 1⅝ × 2⅜ in

glue to the post

on the base

1⅝ in

2

⅜ in
