michaellomuscio/fulcrum/guide/img/hero.png

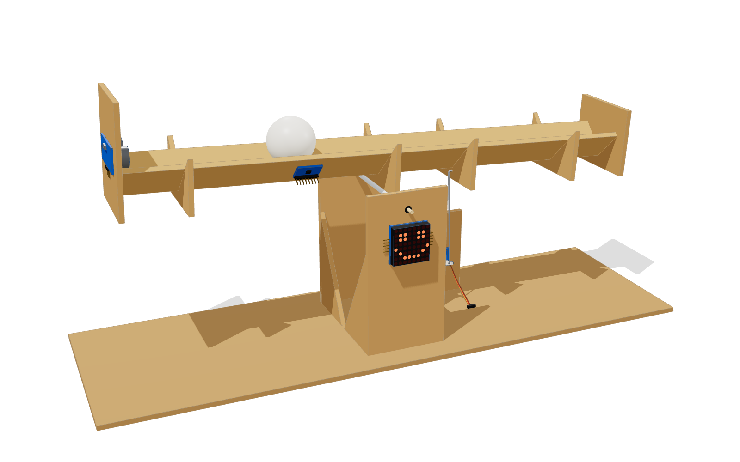
guide/img/hero.png
