michaellomuscio/fulcrum/firmware/Fulcrum/factory_brain.h

// Fulcrum brain "starter" (544 bytes), exported from the Gym.
// Replace firmware/Fulcrum/factory_brain.h with this file to bake the brain into the firmware.
#pragma once
#include <avr/pgmspace.h>
const uint16_t FACTORY_BRAIN_LEN = 544;
const uint8_t FACTORY_BRAIN[] PROGMEM = {
  0x46, 0x42, 0x01, 0x01, 0x06, 0x10, 0x10, 0x01, 0x73, 0x74, 0x61, 0x72, 0x74, 0x65, 0x72, 0x00,
  0x00, 0x00, 0x00, 0x00, 0x3e, 0xe1, 0xcf, 0x6a, 0x27, 0x97, 0x08, 0x3f, 0x48, 0x4c, 0x16, 0x3c,
  0x0a, 0x25, 0xde, 0xec, 0x07, 0x1f, 0x01, 0xdb, 0x0f, 0x22, 0xe7, 0xf2, 0x72, 0x2c, 0x20, 0x1e,
  0x25, 0x44, 0xe9, 0x9d, 0xdb, 0xdb, 0x05, 0xf4, 0xe8, 0xf8, 0xe8, 0x16, 0xf9, 0xe7, 0x46, 0x21,
  0x11, 0xeb, 0x07, 0xa4, 0x5e, 0x27, 0xfe, 0x0a, 0x1b, 0x04, 0xb1, 0xbe, 0x0a, 0xf2, 0xea, 0xf4,
  0x38, 0x7c, 0xee, 0x21, 0x11, 0x23, 0x26, 0x62, 0xd5, 0xfc, 0x03, 0xd4, 0x25, 0x7f, 0xe9, 0xe0,
  0x01, 0x1e, 0xa4, 0x9e, 0xc8, 0x2b, 0x31, 0xfa, 0x01, 0x4f, 0xf5, 0x23, 0xc0, 0x0e, 0xf8, 0xcc,
  0x14, 0xc8, 0xbb, 0xdd, 0x50, 0x29, 0xc5, 0x4c, 0xef, 0xd6, 0x3c, 0x68, 0x33, 0x17, 0x34, 0xde,
  0x3c, 0x0b, 0x34, 0x3d, 0x48, 0x2e, 0xa3, 0x3d, 0xd0, 0x5c, 0x00, 0xbd, 0x4a, 0x43, 0x9d, 0xbd,
  0x92, 0x26, 0xcb, 0xbd, 0x75, 0x29, 0xa8, 0xbd, 0xf5, 0x9b, 0x4c, 0xbd, 0xdc, 0xf2, 0x57, 0x3d,
  0x09, 0x40, 0xa6, 0xbb, 0x7b, 0xa5, 0x07, 0xbd, 0xaf, 0x48, 0x4b, 0x3d, 0x0b, 0x4e, 0x0a, 0x3d,
  0x3d, 0xb2, 0x83, 0x3d, 0x77, 0xf3, 0x82, 0xbb, 0x9b, 0x61, 0x67, 0x3d, 0x0d, 0xd7, 0x5c, 0xbc,
  0xc5, 0x4e, 0x1a, 0x3c, 0x00, 0x0d, 0x96, 0x1f, 0xf9, 0xc8, 0xc9, 0xec, 0xc3, 0xfd, 0xeb, 0x23,
  0x05, 0xff, 0xaa, 0x12, 0xd5, 0xd6, 0x06, 0xbf, 0xfa, 0x3e, 0xff, 0xe0, 0x70, 0x1d, 0x23, 0xb8,
  0xf1, 0xdf, 0xfa, 0x18, 0x04, 0xd4, 0xf1, 0xf4, 0x1a, 0x42, 0x3f, 0x0f, 0xe4, 0x2b, 0x05, 0xeb,
  0x14, 0xe2, 0x09, 0x1a, 0x08, 0x56, 0xdc, 0xeb, 0x3d, 0x0f, 0xe3, 0x46, 0xd1, 0xfb, 0xfc, 0x1f,
  0xd7, 0xf3, 0xd4, 0xb9, 0xfc, 0x1c, 0x3f, 0x11, 0x12, 0x60, 0x00, 0xc3, 0x2d, 0x20, 0x2a, 0x18,
  0x47, 0x11, 0xe1, 0x24, 0xf9, 0xf1, 0xf0, 0xd9, 0x07, 0x12, 0xda, 0xd9, 0xa3, 0xfe, 0xe5, 0xdd,
  0x2f, 0xed, 0x10, 0xd7, 0x33, 0xe3, 0x22, 0xf7, 0x1e, 0x0f, 0xbb, 0xca, 0x06, 0xe2, 0x05, 0x10,
  0xd3, 0xed, 0x1a, 0xed, 0xb5, 0x00, 0xff, 0xf3, 0x3c, 0xe7, 0x09, 0xf3, 0xdf, 0xfb, 0x90, 0x16,
  0xe5, 0x32, 0xcd, 0xe9, 0xdf, 0xfa, 0xc5, 0x29, 0x0c, 0x03, 0x0f, 0x15, 0xf2, 0x81, 0xef, 0x1d,
  0x1b, 0xe0, 0xe3, 0xc6, 0xf4, 0xd2, 0x20, 0xd0, 0x48, 0xd9, 0x09, 0x05, 0x02, 0xfc, 0x53, 0x1b,
  0x24, 0x10, 0x1f, 0x2b, 0x26, 0xe3, 0x27, 0x14, 0x02, 0xce, 0xe2, 0x44, 0xf7, 0x05, 0xe4, 0xe7,
  0x27, 0xe1, 0xab, 0xde, 0xdd, 0xf5, 0x1a, 0x14, 0x04, 0xf1, 0xec, 0xf4, 0x33, 0x39, 0xee, 0x41,
  0x1c, 0xaf, 0x3f, 0xed, 0xd0, 0xea, 0xef, 0x4f, 0x18, 0x16, 0xa9, 0x50, 0xc2, 0xe5, 0xdd, 0xf8,
  0xe8, 0x20, 0xf8, 0x09, 0xf7, 0xd2, 0xe2, 0xe8, 0xb8, 0x08, 0xe4, 0x39, 0xc3, 0xed, 0xeb, 0x59,
  0xf2, 0x3b, 0xca, 0xb7, 0xe8, 0x05, 0xa7, 0x23, 0x16, 0xee, 0xd9, 0x16, 0xf2, 0x08, 0xff, 0x04,
  0x14, 0x52, 0x10, 0xb9, 0xbd, 0x06, 0x2c, 0x11, 0xe6, 0xfc, 0x0f, 0xdf, 0xe7, 0x2c, 0x5e, 0xe0,
  0xe5, 0xdf, 0xfc, 0xef, 0xb7, 0xcc, 0x48, 0x3c, 0x39, 0x0d, 0xc6, 0xbc, 0x14, 0xb8, 0xd7, 0xbd,
  0x8d, 0x26, 0x6e, 0x3d, 0xbd, 0xab, 0x26, 0xbd, 0xf5, 0x8d, 0x23, 0x3c, 0xe5, 0x63, 0x1d, 0xbd,
  0xca, 0x23, 0x99, 0xbd, 0xeb, 0x1f, 0x4f, 0x3d, 0x7c, 0xb5, 0x22, 0x3d, 0xd5, 0xfa, 0x88, 0x3c,
  0xeb, 0x89, 0xa1, 0x3c, 0x0c, 0xf0, 0xc2, 0xbc, 0x0d, 0x1f, 0xa4, 0x3c, 0x4a, 0x0d, 0x8a, 0xbc,
  0x7f, 0x84, 0x2e, 0xbd, 0xff, 0x9c, 0xe1, 0x3a, 0x53, 0x9b, 0xe3, 0x3f, 0x89, 0x18, 0xf4, 0x5e,
  0x69, 0xdd, 0x1a, 0xe1, 0x4a, 0x7f, 0x10, 0xd2, 0x58, 0x3a, 0x89, 0xbd, 0xde, 0xc1, 0x96, 0xcb
};
