michaellomuscio/fulcrum/tests/sil/EEPROM.h

#pragma once
#include "Arduino.h"
struct EEPROMClass {
  uint8_t mem[1024];
  EEPROMClass() { memset(mem, 0xFF, sizeof mem); }   // a fresh Uno's EEPROM is all 0xFF
  uint8_t read(int a) { return mem[a]; }
  void write(int a, uint8_t v) { mem[a] = v; }
  void update(int a, uint8_t v) { mem[a] = v; }
  template <class T> T &get(int a, T &t) { memcpy(&t, mem + a, sizeof(T)); return t; }
  template <class T> const T &put(int a, const T &t) { memcpy(mem + a, &t, sizeof(T)); return t; }
};
extern EEPROMClass EEPROM;
