michaellomuscio/fulcrum/(commit log)

2026-10-14 Fulcrum: a cardboard robot that learns to balance a ball in a simulator, then for real
    A ball-and-beam robot built from an ELEGOO Most Complete Starter Kit. Its brain, a small
    neural network trained with PPO and domain randomization in a browser Gym, is compressed
    to 544 bytes and sent over USB into the Arduino's EEPROM.
    Includes the Arduino firmware, the Gym (training, exam, USB link, firmware installer,
    virtual robot), a narrated build guide with 3D illustrations, wiring diagrams and cut
    templates, and tests that check the firmware against the simulator.
2026-10-14 Host the guide and the Gym on GitHub Pages
    The guide opens at the site root; the Gym at /gym/ can reach the Arduino over USB
    (Web Serial needs https or localhost). Guide step 3.1, its narration, the README and
    the Gym's no-USB note now point to the hosted copy, with the Mac launcher as the
    offline option.
2026-10-17 Give the build measurements in inches
    Cut sizes, marks and hole positions are now whole eighths of an inch, so the
    beam can be built with an ordinary ruler: guide text, narration, cut-template
    PDF (with a 2 inch check bar), 3D illustration labels and BUILD_SPEC.md. The
    simulator and firmware keep their metric geometry; every inch size is within
    1/8 in of it.
